NUSTARS/2019-NSL-rocketADS/README.md

# rocketADS
Software and Hardware for an active drag system for the Nasa Student Launch Competition
