NUSTARS/2019-NSL-rocketADS/eagle/ADS Boards/Main Board.dxf

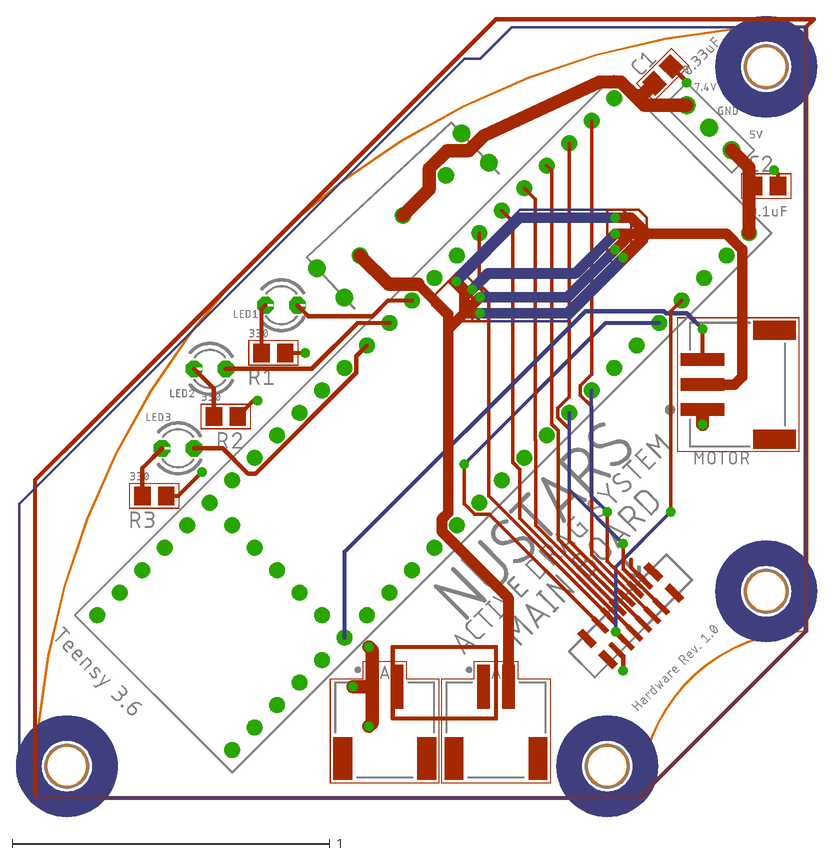
[picture p1: CAD file, 2019-02-10]
eagle/ADS Boards/Main Board.dxf
2.52 x 2.52
