NUSTARS/2019-NSL-rocketADS/eagle/ADS Boards/Sensor Board.dxf

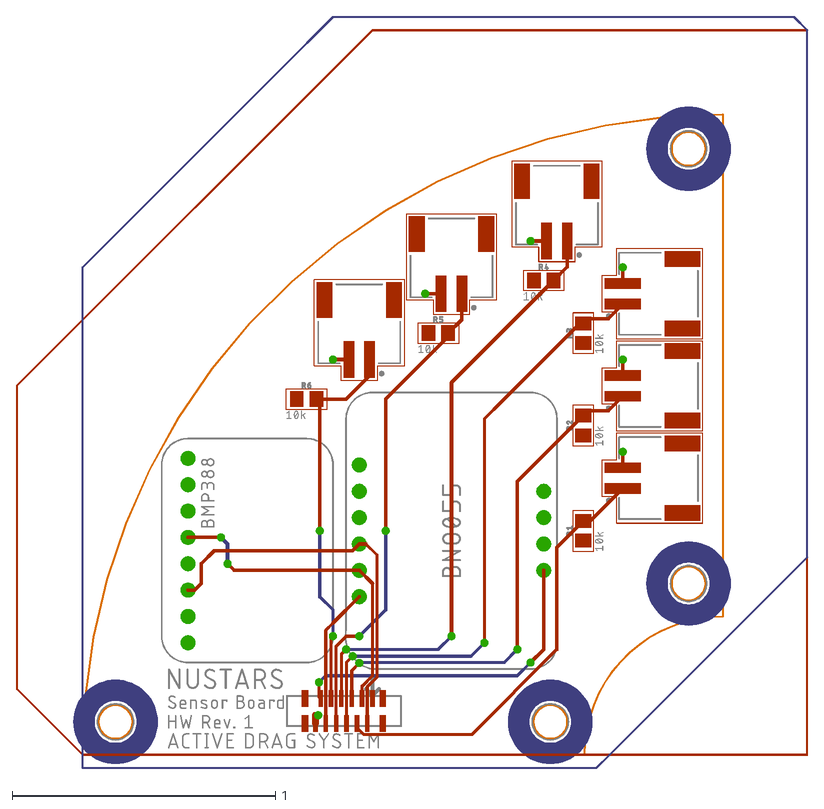
[picture p2: CAD file, 2019-02-10]
eagle/ADS Boards/Sensor Board.dxf
3.01 x 2.86
