NUSTARS/2019-NSL-rocketADS/eagle/ADS Boards/Main Board.brd

## EAGLE design eagle/ADS Boards/Main Board.brd (2019-02-16)

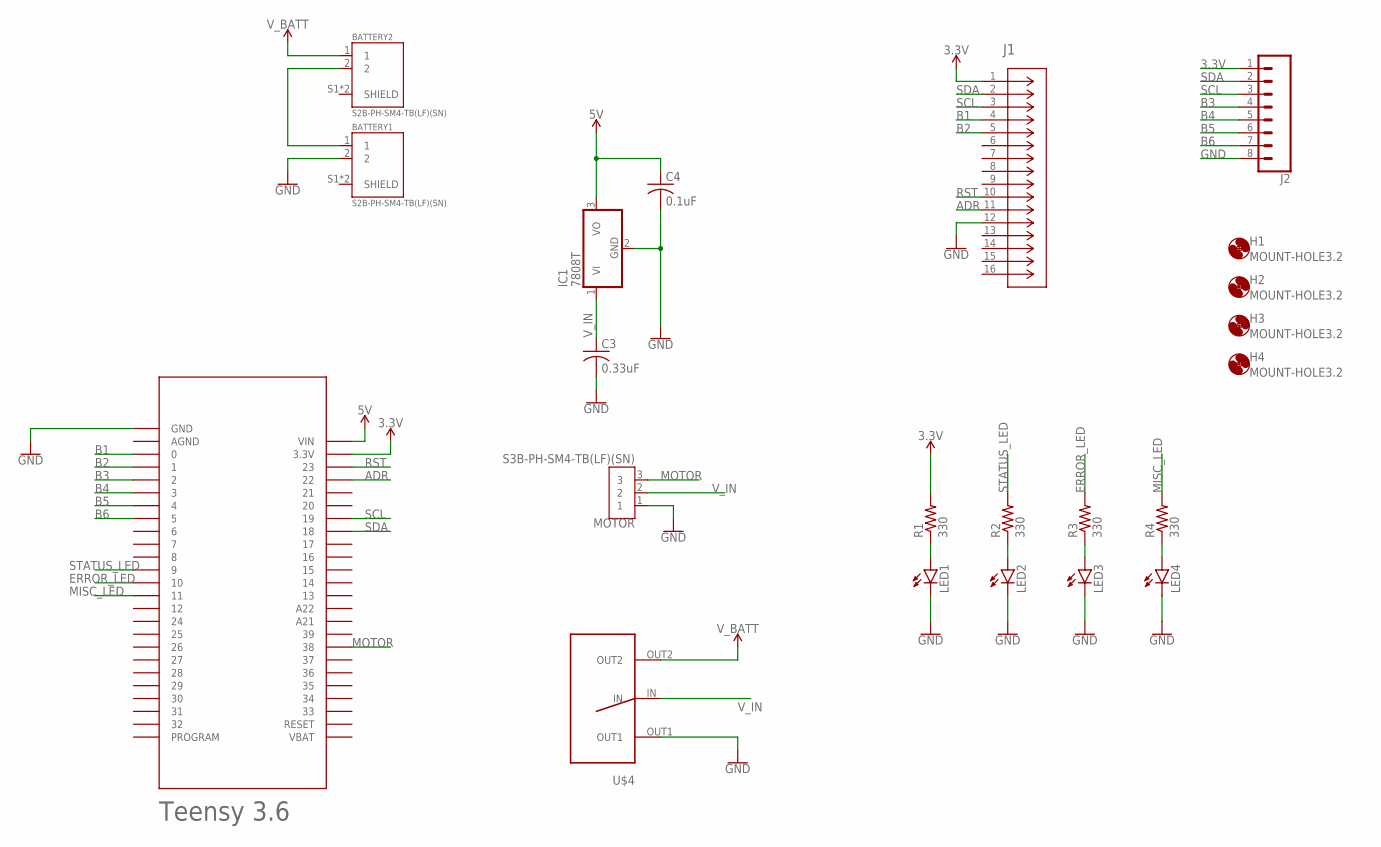
[picture p3: schematic Main Board.sch]

Parts:
BATTERY1, BATTERY2: S2B-PH-SM4-TB(LF)(SN); JST_S2B-PH-SM4-TB(LF)(SN)
C3: 0.33uF; C0805
C4: 0.1uF; C0805
H1, H2, H3, H4: MOUNT-HOLE3.2; 3,2
IC1: 7808T; TO220H
J1: 62674-121121ALF; CON12_1X12_DUT_58XF
J2: CONN_08"; 1X08
LED1, LED2, LED3, LED4: LEDSML0805; SML0805
MOTOR: S3B-PH-SM4-TB(LF)(SN); JST_S3B-PH-SM4-TB(LF)(SN)
R1, R2, R3, R4: 330; R0805
U$1: TEENSY3.6
U$4: SLIDE_SWITCH2

Connections:
3.3V: J1.1 (11), J2.1, R1.2, U$1.3.3V0 (3.3V), U$1.3.3V1 (3.3V), U$1.3.3V2 (3.3V)
5V: C4.1, IC1.3 (VO), U$1.VIN
ADR: J1.11 (1111), U$1.P22 (22)
B1: J1.4 (44), U$1.P0 (0)
B2: J1.5 (55), U$1.P1 (1)
B3: J2.4, U$1.P2 (2)
B4: J2.5, U$1.P3 (3)
B5: J2.6, U$1.P4 (4)
B6: J2.7, U$1.P5 (5)
ERROR_LED: R3.2, U$1.P10 (10)
GND: BATTERY1.2, C3.2, C4.2, IC1.2 (GND), J1.12 (1212), J2.8, LED1.C, LED2.C, LED3.C, LED4.C, MOTOR.1, U$1.GND, U$1.GND0 (GND), U$1.GND2 (GND), U$4.OUT1
MISC_LED: R4.2, U$1.P11 (11)
MOTOR: MOTOR.3, U$1.P38 (38)
unnamed: LED1.A, R1.1
unnamed: BATTERY1.1, BATTERY2.2
unnamed: LED2.A, R2.1
unnamed: LED3.A, R3.1
unnamed: LED4.A, R4.1
RST: J1.10 (1010), U$1.P23 (23)
SCL: J1.3 (33), J2.3, U$1.P19 (19)
SDA: J1.2 (22), J2.2, U$1.P18 (18)
STATUS_LED: R2.2, U$1.P9 (9)
V_BATT: BATTERY2.1, U$4.OUT2
V_IN: C3.1, IC1.1 (VI), MOTOR.2, U$4.IN

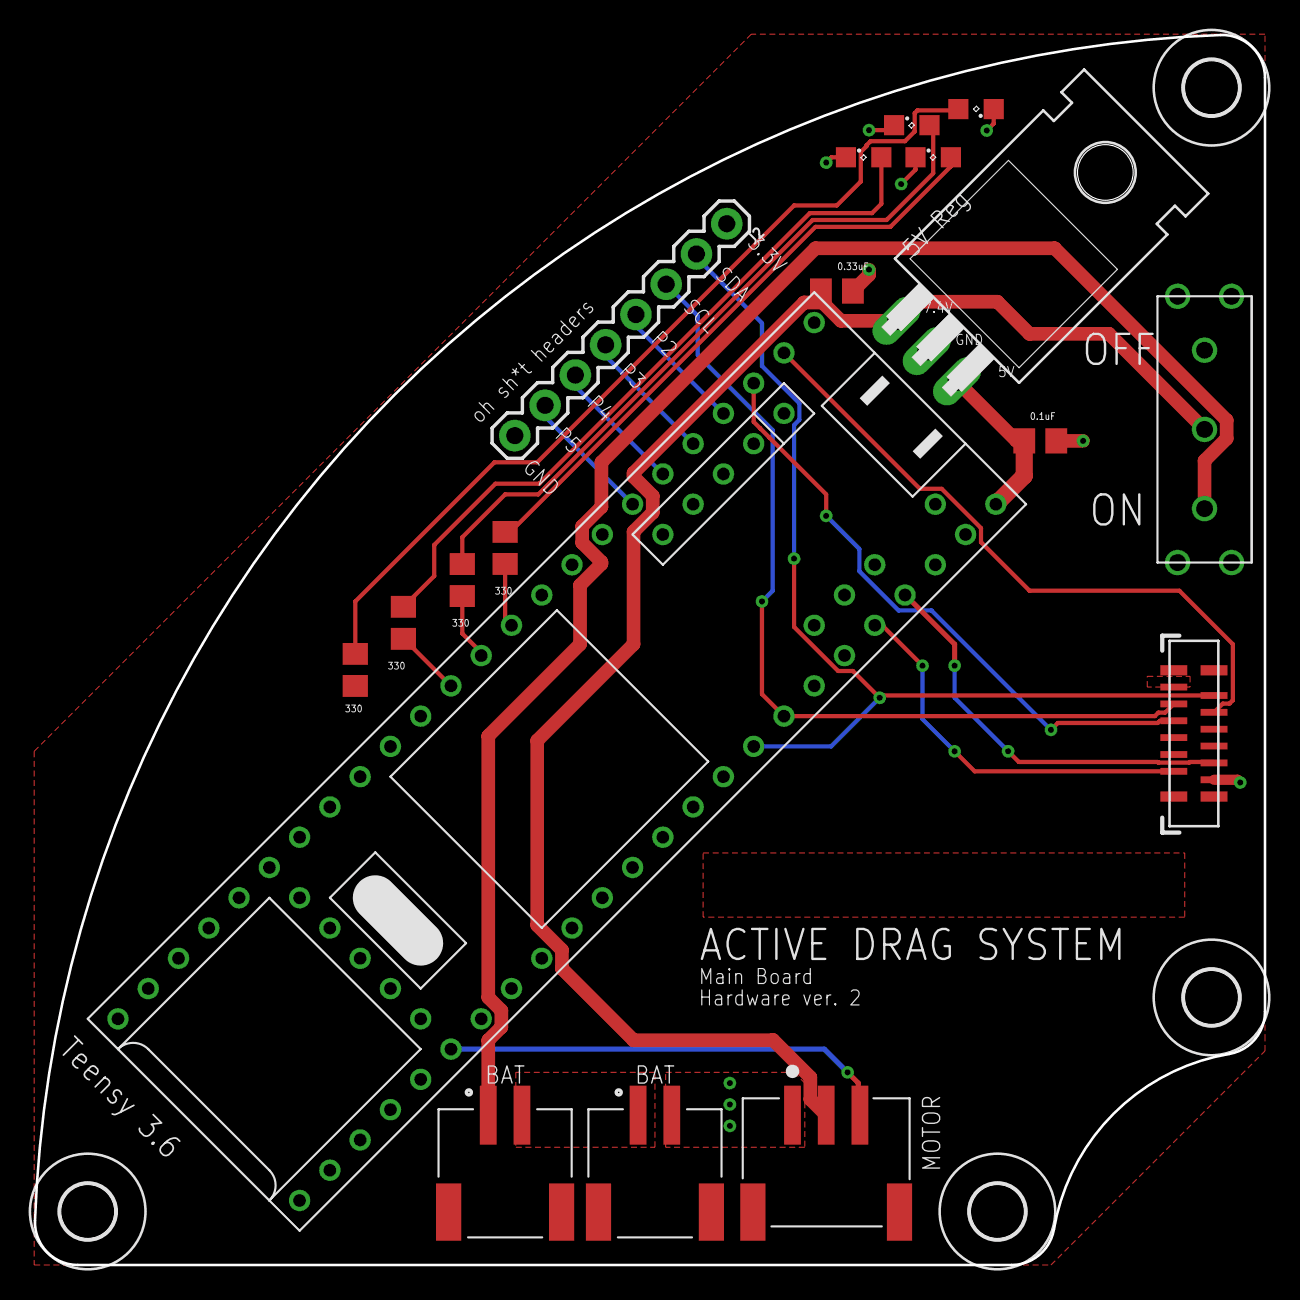
[picture p4: board Main Board.brd from above]

Board: 2 copper layers, 73.0 x 73.0 mm, 22 parts (0 on the bottom side), 24 nets.
