NUSTARS/2019-NSL-rocketADS/eagle/ADS Boards/Sensor Board.brd

## EAGLE design eagle/ADS Boards/Sensor Board.brd (2019-02-16)

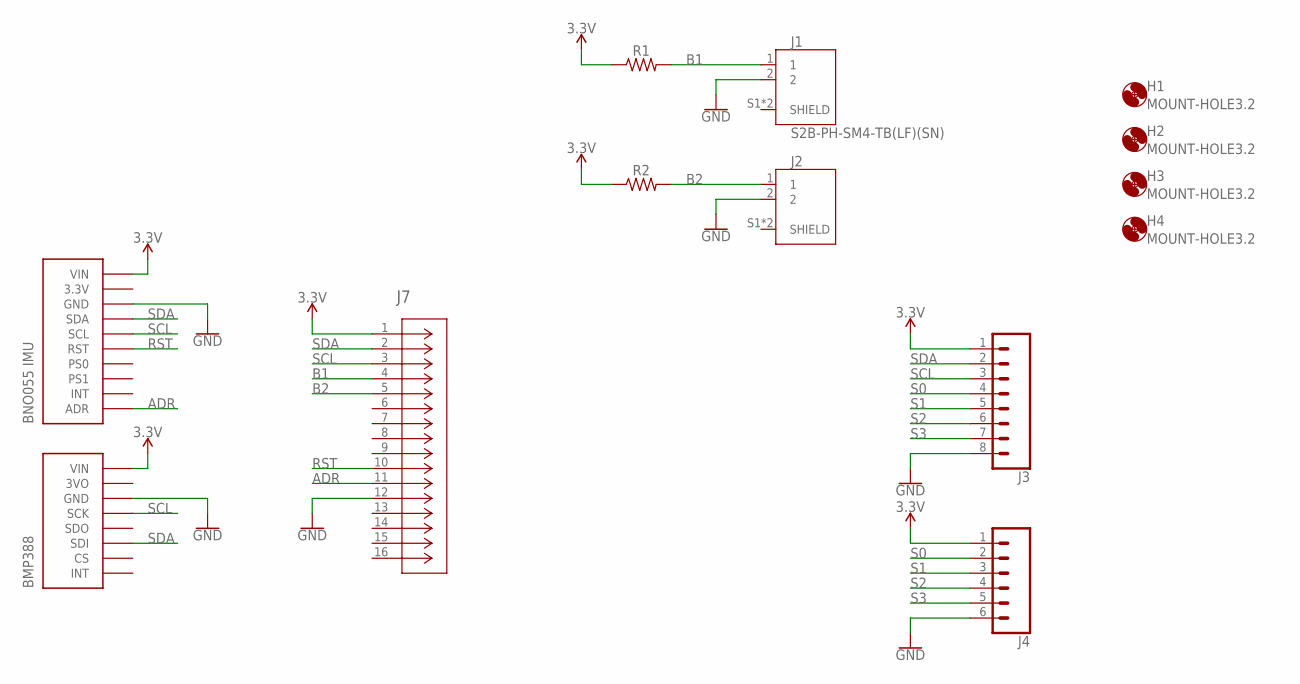
[picture p5: schematic Sensor Board.sch]

Parts:
H1, H2, H3, H4: MOUNT-HOLE3.2; 3,2
J1, J2: S2B-PH-SM4-TB(LF)(SN); JST_S2B-PH-SM4-TB(LF)(SN)
J3: CONN_08"; 1X08
J4: CONN_06SILK_FEMALE_PTH; 1X06
J7: 62674-121121ALF; CON12_1X12_DUT_58XF
R1, R2: 10k; R0805
U$1: BMP388
U$2: BNO055

Connections:
3.3V: J3.1, J4.1, J7.1 (11), R1.1, R2.1, U$1.VIN, U$2.VIN
ADR: J7.11 (1111), U$2.ADR
B1: J1.1, J7.4 (44), R1.2
B2: J2.1, J7.5 (55), R2.2
GND: J1.2, J2.2, J3.8, J4.6, J7.12 (1212), U$1.GND, U$2.GND
RST: J7.10 (1010), U$2.RST
S0: J3.4, J4.2
S1: J3.5, J4.3
S2: J3.6, J4.4
S3: J3.7, J4.5
SCL: J3.3, J7.3 (33), U$1.SCK, U$2.SCL
SDA: J3.2, J7.2 (22), U$1.SDI, U$2.SDA

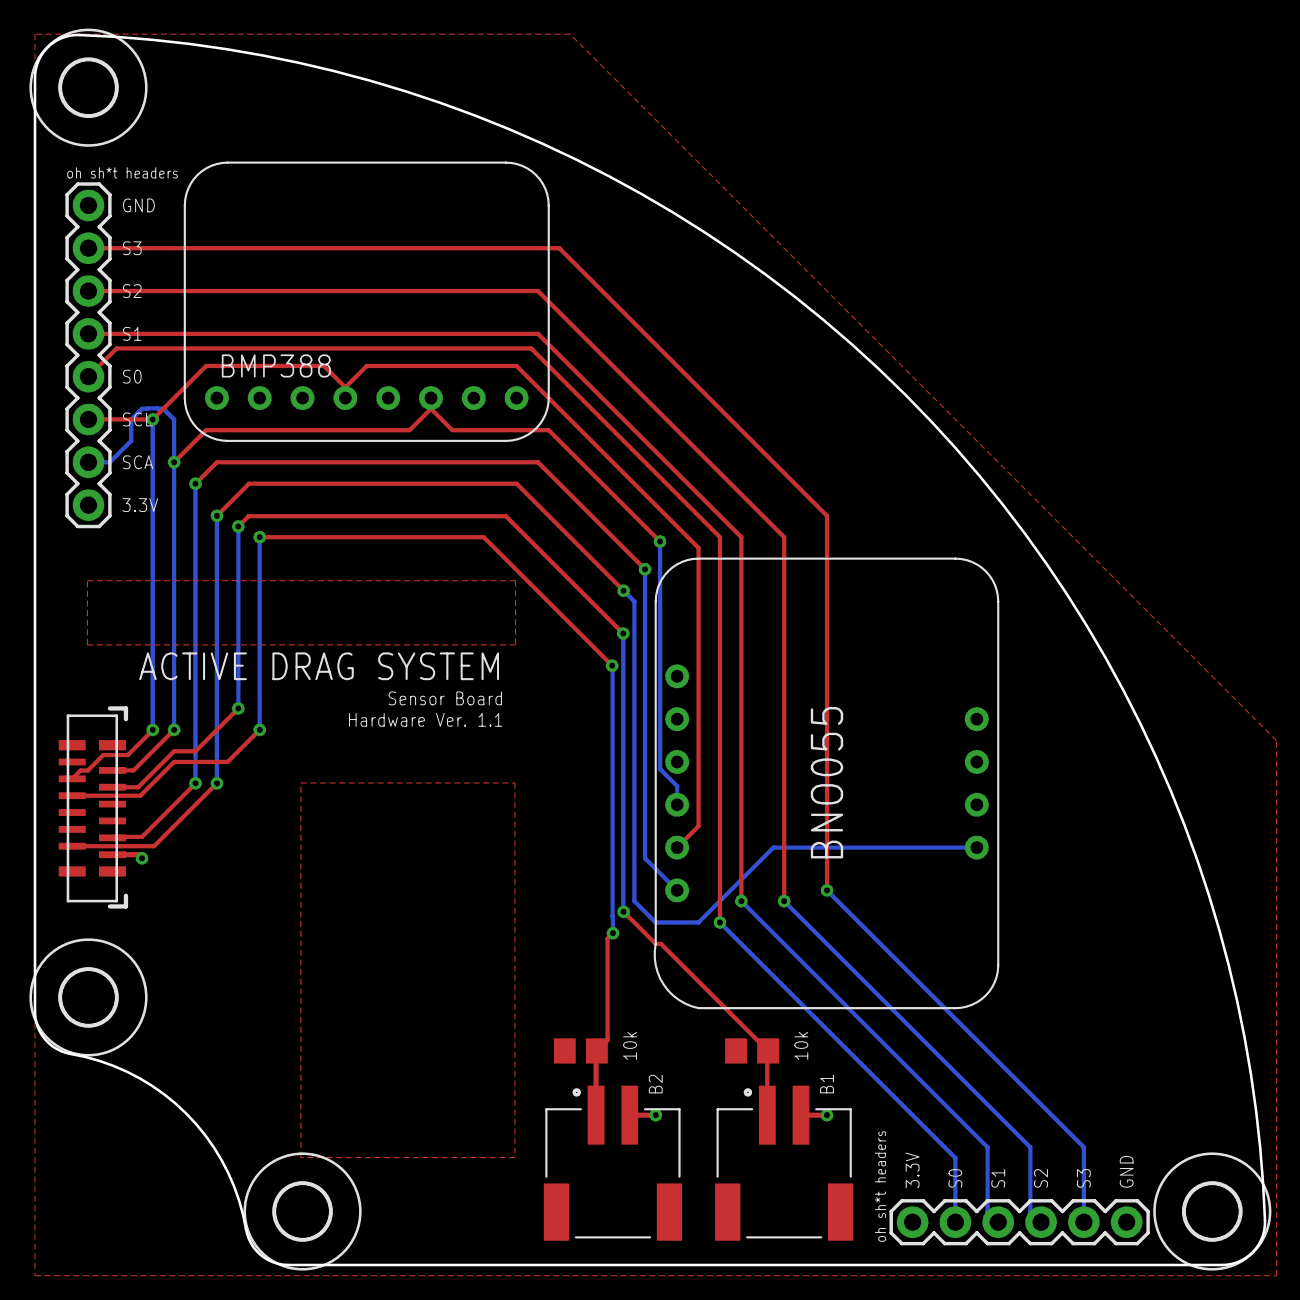
[picture p6: board Sensor Board.brd from above]

Board: 2 copper layers, 73.0 x 73.0 mm, 13 parts (0 on the bottom side), 12 nets.
