NUSTARS/2019-NSL-rocketADS/(threads)

Thread 2 (2018-11-25):

Create CAD for Airbrakes

ichisaur, 2018-11-25:
- [ ] create cad
- [ ] have someone check over cad

ichisaur, 2018-12-27:
- [ ] Check electronics passthroughs
- [ ] Check button placements
- [ ] Check manufacturability

Closed 2019-02-07.

Thread 5 (2018-11-25):

Create Electronics CAD boards

ichisaur, 2018-11-25:
- [x] create boards
- [ ] check boards over

ichisaur, 2018-12-27:
Working on final checks and polishes

ichisaur, 2019-01-13:
Need to double check w/ changes to surface mount. Possibly change out slide siwtches

Closed 2019-02-07.

Thread 10 (2019-02-07):

Test Power Delivery System

ichisaur, 2019-02-07:
Power delivery system and 5v regulation needs to be done to test voltage regulator.

Ensure the use of the power adapter leads otherwise the boards will definitely fry.
Ensure power of battery delivery is 7.4 volts (or approximately so)

Ensure battery voltages are correct

Schematics need to be checked for voltage regulator and proper orientation noted down.
Scope all inputs to Arduino 3.7-6 volt input and ground to ensure correct voltages.

ichisaur, 2019-02-08:
Power systems tested without issues. However it appears that you should probably not charge the system with power system in place

Closed 2019-02-08.

Thread 12 (2019-02-07):

3D print battery bracket

ichisaur, 2019-02-07:
Need to 3d print the brackets to hold battery subsystems

And maybe for nose cone lock as well.

ichisaur, 2019-02-08:
Printed. Next time use smaller layers or something tho.

Closed 2019-02-08.

Thread 13 (2019-02-07):

Implement Interrupt Based Datalogging

ichisaur, 2019-02-07:
Trigger data reads through the use of Arduino Interrupts to occur at certain intervals of time.

ichisaur, 2019-02-08:
Implemented and done. However there are certain aspects that seem like they should be taken out of the interrupt and placed into other ones.

Closed 2019-02-08.

Thread 14 (2019-02-07):

Fix Errant BNO Sensor

ichisaur, 2019-02-07:
BNO on breadboard has been modified to use 330 ohm pull-up resistors.

Resolder to use 10k ohm resistors instead.

ichisaur, 2019-02-08:
Issue is now fixed. The fixed chips have resistors labled 103 instead of 1002

Closed 2019-02-08.

Thread 17 (2019-02-07):

Sensor Reading and filtering

ichisaur, 2019-02-07:
Read and filter in sensor data, implementing kalman/lpf/lms filters and altitude adjustments. Data processing to obtain approximate velocities of rocket.

Closed 2019-11-11.

Thread 9 (2019-02-07):

Redesign Main Board

ichisaur, 2019-02-07:
Main board has several issues:
Hole sizes for components are too small - especially for power switch.
Placement of power adapter hinders access to mini-usb port
Polarity of power leads are swapped
Orientation of ribbon cable should be swapped as well
Logo needs to be improved and more visible

Closed 2019-11-11.

Thread 19 (2019-02-08):

Implement error sensing SD Card

ichisaur, 2019-02-08:
Find out when SD card cannot be opened or written to and turn on error LED when that state occurs.

ichisaur, 2019-02-10:
implemented error LED, however did not implement a way for data storage to be recovered on event of failure

Closed 2019-11-11.

Thread 20 (2019-02-08):

Implement Altimeter Error Sensing

ichisaur, 2019-02-08:
Implement reading of i2c ID register to determine that altimeter is connected and functioning, otherwise toggle Error LED

Closed 2019-11-11.

Thread 21 (2019-02-08):

Implement Battery Charging Circuit

ichisaur, 2019-02-08:
Implement battery charging circuit so we can charge the batteries and monitor them.

ichisaur, 2019-02-10:
Needs to be more permanent.

Closed 2019-11-11.

Thread 23 (2019-02-08):

Implement Battery Charging Readout Circuit

ichisaur, 2019-02-08:
For Easy battery percentage on the go!

ichisaur, 2019-02-10:
Battery circuit done, but should be implemented in a better, more permanent manner

ichisaur, 2019-02-10:
Needs an LCD display as well

Closed 2019-11-11.
