NUSTARS/2019-NSL-rocketADS/rawdata_modified/rawdata_modified.ino

#include <Wire.h>
#include <Adafruit_Sensor.h>
#include <Adafruit_BNO055.h>
#include <utility/imumaths.h>
#include <Adafruit_BMP3XX.h>

#define SEALEVELPRESSURE_HPA (1013.25)

/* This driver reads raw data from the BNO055

   Connections
   ===========
   Connect SCL to analog 5
   Connect SDA to analog 4
   Connect VDD to 3.3V DC
   Connect GROUND to common ground

   History
   =======
   2015/MAR/03  - First release (KTOWN)
*/

/* Set the delay between fresh samples */
#define BNO055_SAMPLERATE_DELAY_MS (100)
Adafruit_BMP3XX bmp;

Adafruit_BNO055 bno = Adafruit_BNO055();

/**************************************************************************/
/*
    Arduino setup function (automatically called at startup)
*/
/**************************************************************************/
void setup(void)
{
  pinMode(13, OUTPUT);
  pinMode(23, OUTPUT);
  digitalWrite(23, HIGH);
  pinMode(22, OUTPUT);
  digitalWrite(22, LOW);
  Serial.begin(9600);
  Serial.println("Orientation Sensor Raw Data Test"); Serial.println("");

  /* Initialise the sensor */
  if(!bno.begin())
  {
    /* There was a problem detecting the BNO055 ... check your connections */
    Serial.print("Ooops, no BNO055 detected ... Check your wiring or I2C ADDR!");
    digitalWrite(13, HIGH);
    while(1);
  }
   if (!bmp.begin()) {  
    digitalWrite(8, HIGH);
    Serial.println("Could not find a valid BMP280 sensor, check wiring!");
    while (1);
  }

  delay(1000);

  /* Display the current temperature */
  int8_t temp = bno.getTemp();
  Serial.print("Current Temperature: ");
  Serial.print(temp);
  Serial.println(" C");
  Serial.println("");

  bno.setExtCrystalUse(true);

  Serial.println("Calibration status values: 0=uncalibrated, 3=fully calibrated");
}

/**************************************************************************/
/*
    Arduino loop function, called once 'setup' is complete (your own code
    should go here)
*/
/**************************************************************************/
void loop(void)
{
  // Possible vector values can be:
  // - VECTOR_ACCELEROMETER - m/s^2
  // - VECTOR_MAGNETOMETER  - uT
  // - VECTOR_GYROSCOPE     - rad/s
  // - VECTOR_EULER         - degrees
  // - VECTOR_LINEARACCEL   - m/s^2
  // - VECTOR_GRAVITY       - m/s^2
  uint8_t testBit = 0;

  byte value = 0;

  Wire.beginTransmission(BNO055_ADDRESS_A);

    Wire.send(bno.BNO055_CHIP_ID_ADDR);

  Wire.endTransmission();
  Wire.requestFrom(BNO055_ADDRESS_A, (byte)1);

    value = Wire.receive();

testBit = value;
Serial.println(testBit);

  
  if (testBit != BNO055_ID) {
    Serial.println("goddamnit");
    while(!bno.begin());
  }
  imu::Vector<3> euler = bno.getVector(Adafruit_BNO055::VECTOR_EULER);

  /* Display the floating point data */
  Serial.print("X: ");
  Serial.print(euler.x());
  Serial.print(" Y: ");
  Serial.print(euler.y());
  Serial.print(" Z: ");
  Serial.print(euler.z());
  Serial.print("\t\t");

  /*
  // Quaternion data
  imu::Quaternion quat = bno.getQuat();
  Serial.print("qW: ");
  Serial.print(quat.w(), 4);
  Serial.print(" qX: ");
  Serial.print(quat.y(), 4);
  Serial.print(" qY: ");
  Serial.print(quat.x(), 4);
  Serial.print(" qZ: ");
  Serial.print(quat.z(), 4);
  Serial.print("\t\t");
  */

  /* Display calibration status for each sensor. */
  uint8_t system, gyro, accel, mag = 0;
  bno.getCalibration(&system, &gyro, &accel, &mag);
  Serial.print("CALIBRATION: Sys=");
  Serial.print(system, DEC);
  Serial.print(" Gyro=");
  Serial.print(gyro, DEC);
  Serial.print(" Accel=");
  Serial.print(accel, DEC);
  Serial.print(" Mag=");
  Serial.println(mag, DEC);


if (! bmp.performReading()) {
    Serial.println("Failed to perform reading :(");
    return;
  }
  Serial.print("Temperature = ");
  Serial.print(bmp.temperature);
  Serial.println(" *C");

  Serial.print("Pressure = ");
  Serial.print(bmp.pressure / 100.0);
  Serial.println(" hPa");

  Serial.print("Approx. Altitude = ");
  Serial.print(bmp.readAltitude(SEALEVELPRESSURE_HPA));
  Serial.println(" m");

  Serial.println();

  delay(1000);
}
