NUSTARS/2019-NSL-rocketADS/(commit log)

2018-12-26 Eagle Schematics for Sensor and Main Boards
    [Main Board.sch, Sensor Board.sch]
2018-12-27 Finish Preliminary Board Layouts
    [DRILEGEND.CFG, Main Board.brd, Main Board.sch, Sensor Board.brd, Sensor Board.sch]
2018-12-27 Convert .dxf files to imperial units
    [Sensor Board.brd]
2019-01-13 Modify to surface mount components
    [Main Board.brd, Main Board.sch, Sensor Board.brd, Sensor Board.sch]
2019-01-27 Finalized Boards, Gerbers, and DXF files.
    [Main Board.brd, Main Board.dxf, Main Board.sch, Sensor Board.brd, Sensor Board.dxf, Sensor Board.sch]
2019-02-08 Sample Code Datalogging
2019-02-08 Datalogger Status LEDS implemented, saving fixed, formatting fixed, optimized execution
    [sensors.cpp, sensors.h, storage.cpp, storage.h]
2019-02-10 battery percentage checks
2019-02-16 fixed rocket boards
    [Main Board.GBL, Main Board.GBO, Main Board.GBP, Main Board.GBS, Main Board.GTL, Main Board.GTO, Main Board.GTP, Main Board.GTS]
2019-02-16 rename several folders for arduino compatibility
2019-02-22 reverting datalogger back to working launch configuration
    [ads.ino, datalogger.ino, sensors.cpp, sensors.h, storage.cpp, storage.h]
2019-02-22 Working ADS motor actuation
2019-03-02 ADS Launch Config
    [Main Board.sch, Sensor Board.sch]
